Mozzle/Drone_Flight_Computer/CAD/Frame/README.md

## Quadcopter Frame

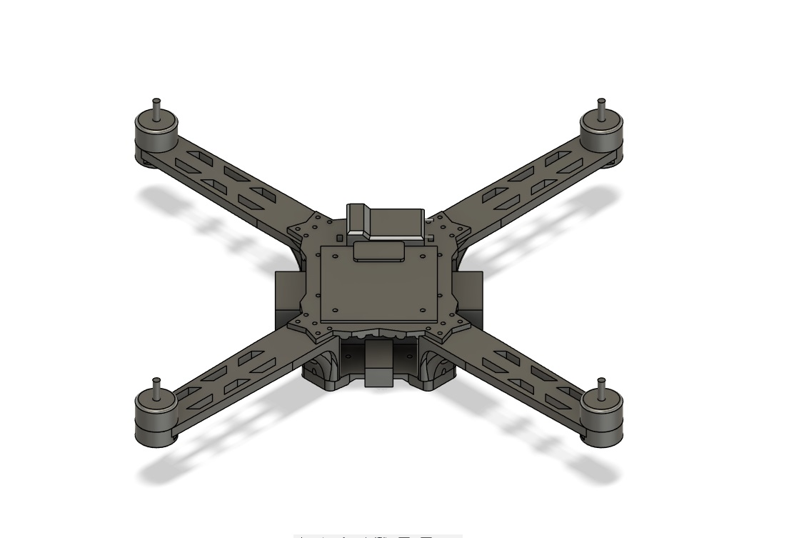
[picture p2: images/Fusion_Quad.jpg]
Picture of the quadcopter in Autodesk Fusion


## Test Stand that I made to test the quadcopter's functionality without risking the hardware. It features pitch and yaw bearings to allow free movement in those axes.

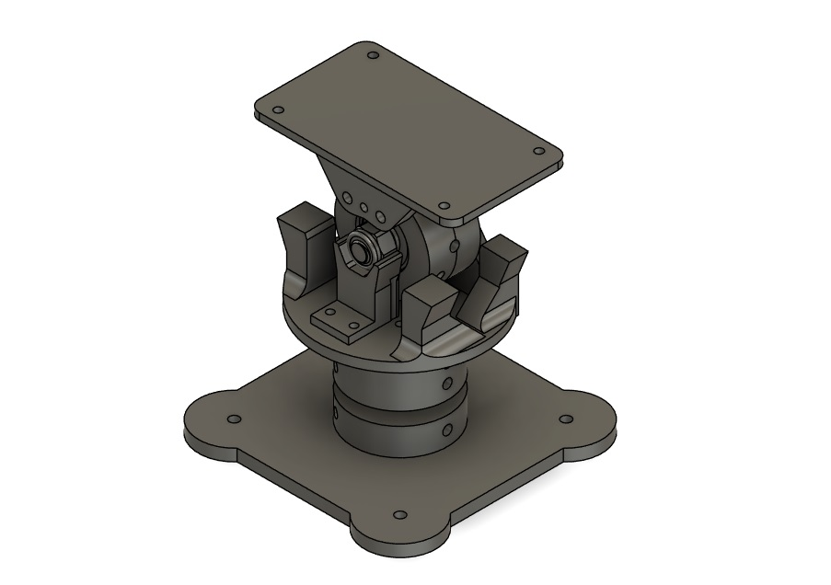
[picture p3: images/Fusion_Stand.jpg]
Picture of the quadcopter test stand in Autodesk Fusion
