Mozzle/Drone_Flight_Computer/CAD/PCB/README.md

## PCB

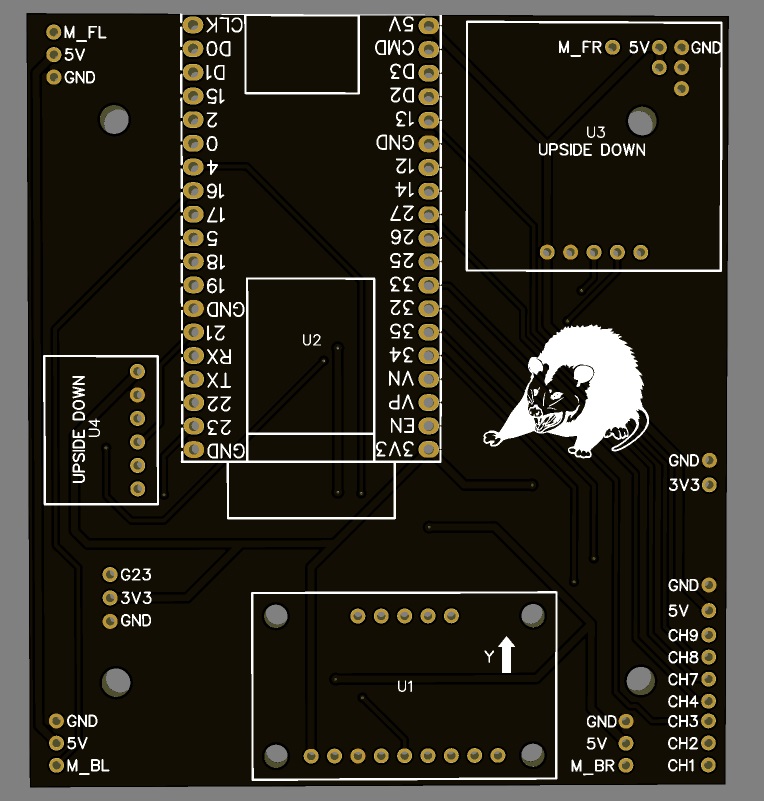
[picture p4: images/Flying_Opossum_PCB.jpg]
Picture of the circuit board in EasyEDA
