Mozzle/Drone_Flight_Computer/(commit log)

2024-12-14 Implemented BMP280 Driver
2024-12-18 Implemented LSM9DS0 driver, added Drone_LIB
2024-12-21 Mode Controller + Motor Output
2024-12-28 Mahoney Filter 4 attitude, PID Controller, Hover Mode
2025-01-07 Hover Changes, Magnetometer Calibration
2025-01-07 Add CAD files, update READMEs
